mjrskiles/cv-gate/models/cv-gate.step

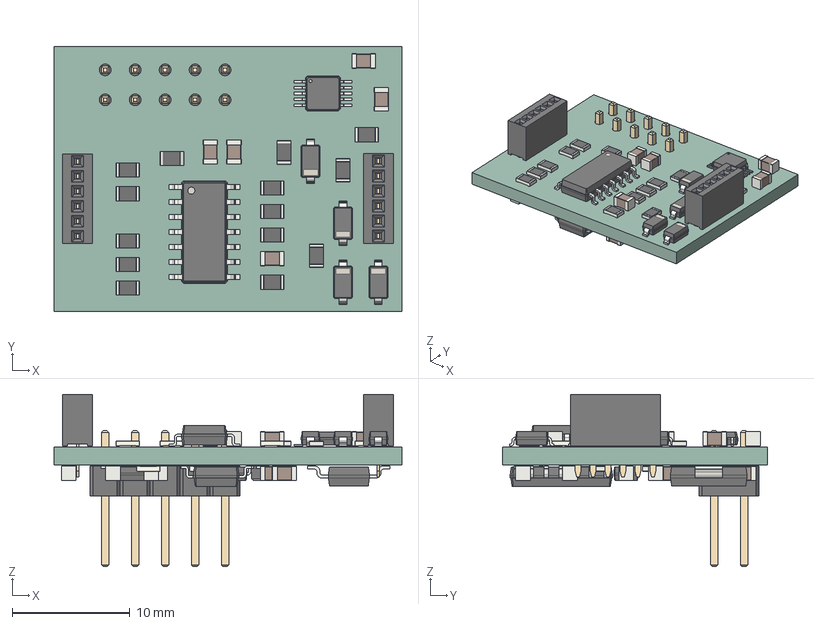
[picture p1: CAD file, 2025-03-12]
models/cv-gate.step
29.5 x 22.5 x 14.6 mm
C_0805_2012Metric x 15
D_SOD-123 x 6
R_0805_2012Metric x 19
PinSocket_1x06_P1.27mm_Vertical x 2
VSSOP-10_3x3mm_P0.5mm
SOIC-14_3.9x8.7mm_P1.27mm x 2
D_SOD-123F x 2
PinHeader_2x05_P2.54mm_Vertical
SOT-223
cv-gate_PCB
