mjrskiles/cv-gate/docs/cv-gate.pdf

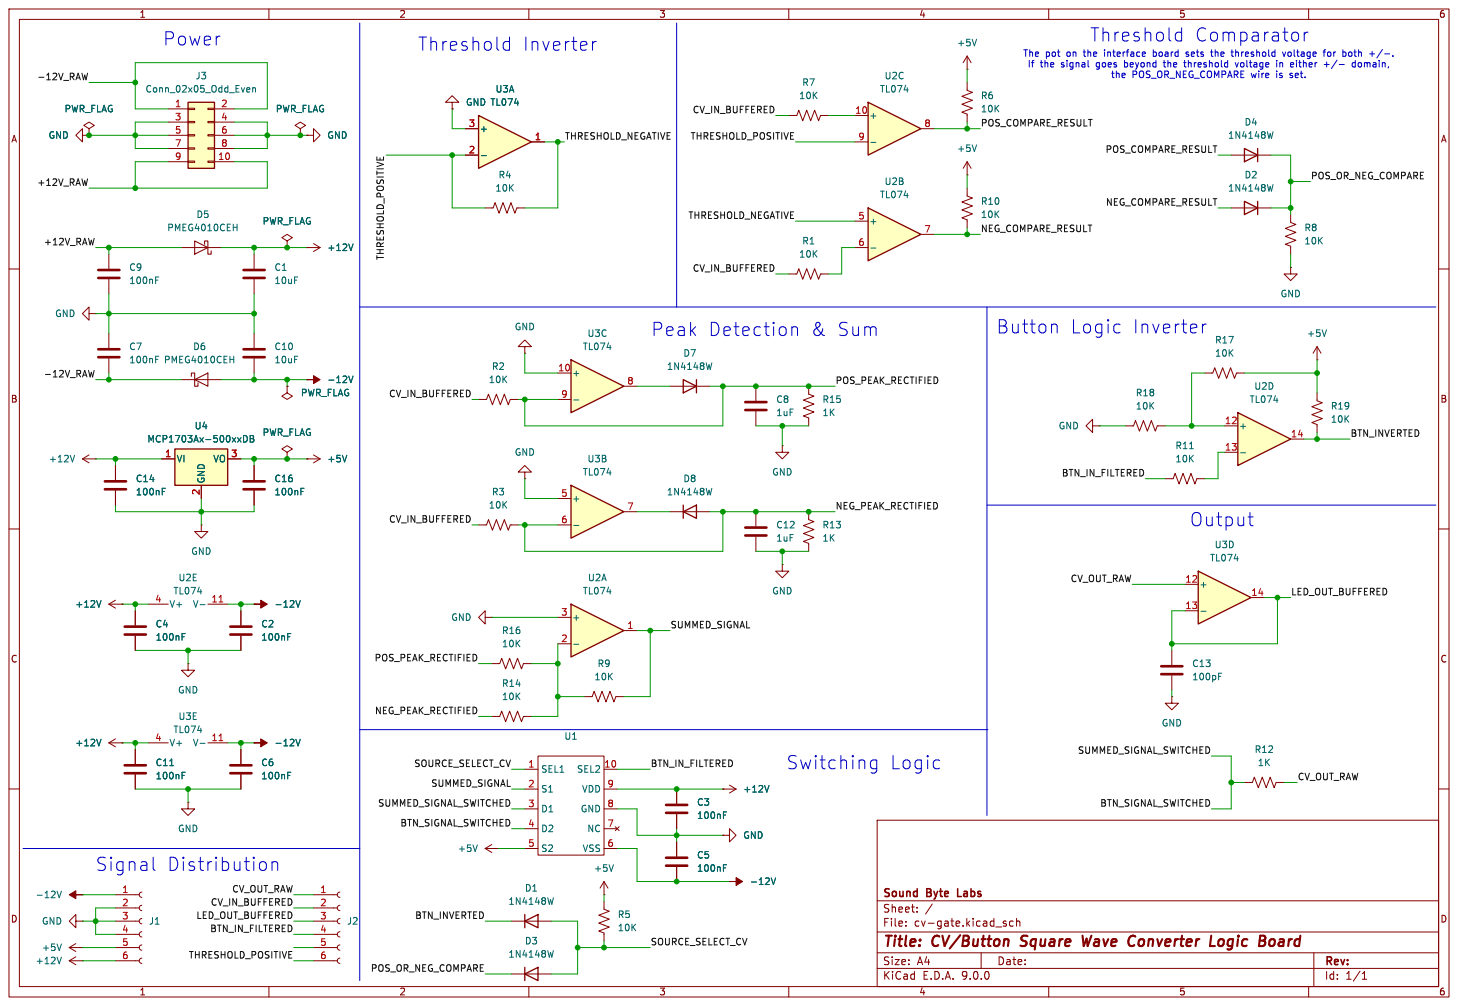
[picture p2: page 1]

Threshold Comparator Threshold Inverter

the POS_OR_NEG_COMPARE wire is set.
