mjrskiles/cv-gate/cv-gate.kicad_pcb

## KiCad design cv-gate.kicad_pcb (2025-03-12)

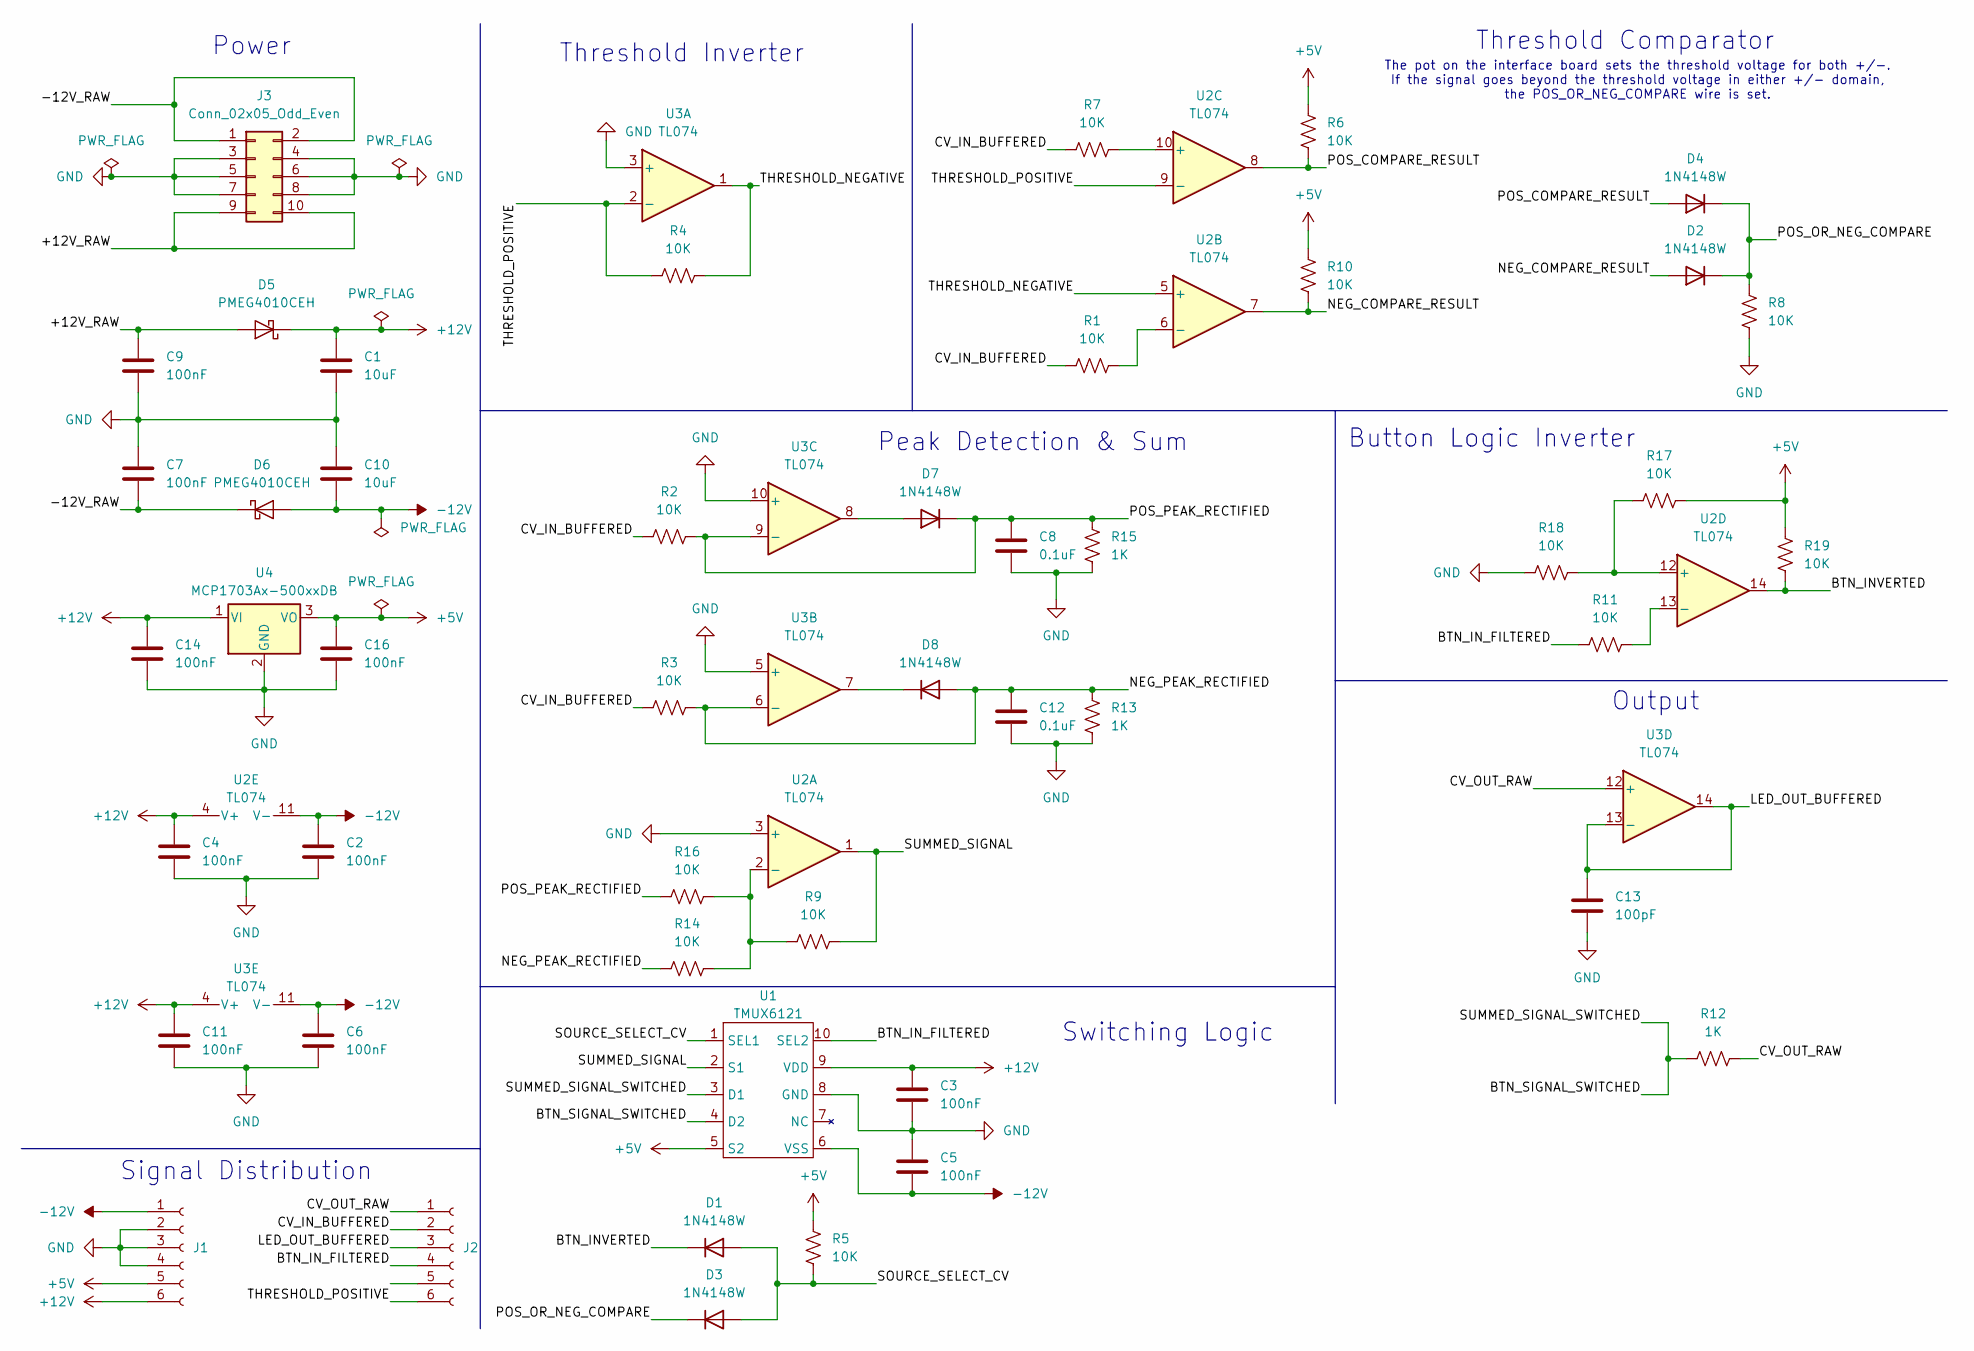
[picture p3: schematic cv-gate.kicad_sch, CV/Button Square Wave Converter Logic Board]

Parts:
C1, C10: 10uF; C_0805_2012Metric_Pad1.18x1.45mm_HandSolder
C2, C3, C4, C5, C6, C7, C9, C11, C14, C16: 100nF; C_0805_2012Metric_Pad1.18x1.45mm_HandSolder
C8, C12: 0.1uF; C_0805_2012Metric_Pad1.18x1.45mm_HandSolder
C13: 100pF; C_0805_2012Metric_Pad1.18x1.45mm_HandSolder
D1, D2, D3, D4, D7, D8: 1N4148W; D_SOD-123
D5, D6: PMEG4010CEH; D_SOD-123F
J1, J2: Conn_01x06_Socket; PinSocket_1x06_P1.27mm_Vertical
J3: Conn_02x05_Odd_Even; PinHeader_2x05_P2.54mm_Vertical
R1, R2, R3, R4, R5, R6, R7, R8, R9, R10, R11, R14, R16, R17, R18, R19: 10K; R_0805_2012Metric_Pad1.20x1.40mm_HandSolder
R12, R13, R15: 1K; R_0805_2012Metric_Pad1.20x1.40mm_HandSolder
U1: TMUX6121; VSSOP-10_3x3mm_P0.5mm
U2, U3: TL074; SOIC-14_3.9x8.7mm_P1.27mm
U4: MCP1703Ax-500xxDB; SOT-223-3_TabPin2

Connections:
+5V: C16.2, J1.5, R5.1, R6.1, R10.1, R17.2, R19.2, U1.5 (S2), U4.3 (VO)
+12V: C1.2, C3.2, C4.2, C11.2, C14.2, D5.1 (K), J1.6, U1.9 (VDD), U2.4 (V+), U3.4 (V+), U4.1 (VI)
-12V: C2.2, C5.1, C6.2, C10.1, D6.2 (A), J1.1, U1.6 (VSS), U2.11 (V-), U3.11 (V-)
/+12V_RAW: C9.2, D5.2 (A), J3.9, J3.10
/-12V_RAW: C7.1, D6.1 (K), J3.1, J3.2
/BTN_INVERTED: D1.1 (K), R19.1, U2.14
/BTN_IN_FILTERED: J2.4, R11.1, U1.10 (SEL2)
/BTN_SIGNAL_SWITCHED: R12.1, U1.3 (D1), U1.4 (D2)
/CV_IN_BUFFERED: J2.2, R1.2, R2.2, R3.2, R7.2
/CV_OUT_RAW: J2.1, R12.2, U3.12 (+)
/LED_OUT_BUFFERED: C13.2, J2.3, U3.13 (-), U3.14
/NEG_COMPARE_RESULT: D2.2 (A), R10.2, U2.7
/NEG_PEAK_RECTIFIED: C12.1, D8.2 (A), R3.1, R13.2, R14.1, U3.6 (-)
/POS_COMPARE_RESULT: D4.2 (A), R6.2, U2.8
/POS_OR_NEG_COMPARE: D2.1 (K), D3.1 (K), D4.1 (K), R8.1
/POS_PEAK_RECTIFIED: C8.1, D7.1 (K), R2.1, R15.2, R16.1, U3.9 (-)
/SOURCE_SELECT_CV: D1.2 (A), D3.2 (A), R5.2, U1.1 (SEL1)
/SUMMED_SIGNAL: R9.2, U1.2 (S1), U2.1
/THRESHOLD_NEGATIVE: R4.1, U2.5 (+), U3.1
/THRESHOLD_POSITIVE: J2.6, R4.2, U2.9 (-), U3.2 (-)
GND: C1.1, C2.1, C3.1, C4.1, C5.2, C6.1, C7.2, C8.2, C9.1, C10.2, C11.1, C12.2, C13.1, C14.1, C16.1, J1.2, J1.3, J1.4, J3.3, J3.4, J3.5, J3.6, J3.7, J3.8, R8.2, R13.1, R15.1, R18.1, U1.8 (GND), U2.3 (+), U3.3 (+), U3.5 (+), U3.10 (+), U4.2 (GND)
unnamed: D7.2 (A), U3.8
unnamed: D8.1 (K), U3.7
unnamed: R9.1, R14.2, R16.2, U2.2 (-)
unnamed: R1.1, U2.6 (-)
unnamed: R7.1, U2.10 (+)
unnamed: R17.1, R18.2, U2.12 (+)
unnamed: R11.2, U2.13 (-)

Notes on the sheet:
The pot on the interface board sets the threshold voltage for both +/-. If the signal goes beyond the threshold voltage in either +/- domain, the POS_OR_NEG_COMPARE wire is set.
Switching Logic
Threshold Inverter
Signal Distribution
Button Logic Inverter
Peak Detection & Sum
Threshold Comparator
Power
Output

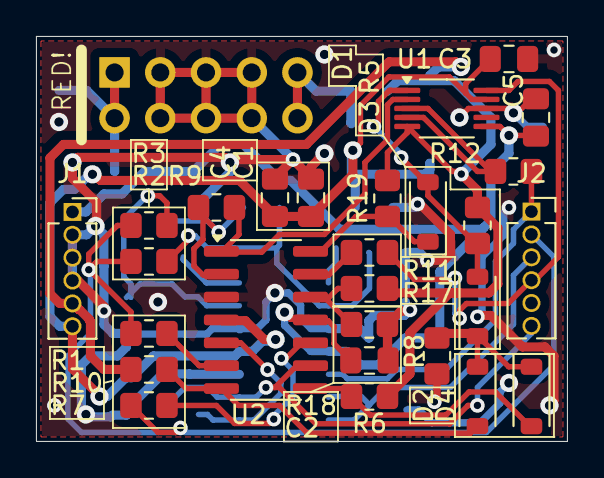
[picture p4: board cv-gate.kicad_pcb from above]

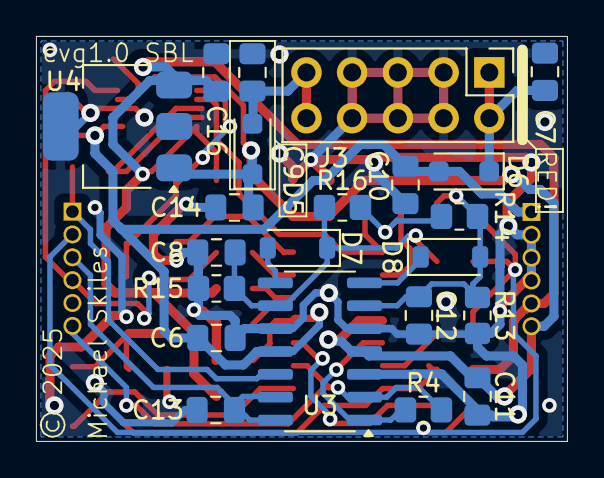
[picture p5: board cv-gate.kicad_pcb from below]

Board: 2 copper layers, 29.5 x 22.5 mm, 49 parts (22 on the bottom side), 28 nets.
