mjrskiles/cv-gate/(commit log)

2025-03-08 Moved I/O buffering to interface board, add license
    [cv-gate.kicad_pcb, cv-gate.kicad_sch]
2025-03-12 Add bom, 3d model
    [cv-gate.csv, cv-gate.kicad_pcb, cv-gate.kicad_sch, cv-gate.step]
