mjrskiles/cv-gate/(notices)

Notices in the files:
cv-gate.kicad_pcb:
© 2025
